fab4U/ProtoCounter_Tx13/ReadMe.md

# ProtoCounter Tx13

A versatile microcontroller system.
For a detailed description see

/documentation/protocounter_english.pdf

This project folder contains the Arduino library for operating the ProtoCounter. You will need the Arduino IDE (recommended version > 1.6) and the extension for ATtiny microcontrollers (https://github.com/SpenceKonde/ATTinyCore).
