fab4U/ProtoCounter_Tx13/documentation/proto-counter.pdf

2019/03/14 22:52 | 1/10 | Proto-Counter

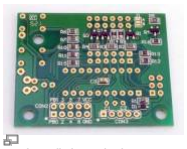
[picture p1: figure]

fab4U - http://www.doku.fab4u.de/

# Proto-Counter

Das universelle Mikrocontroller-Modul

ATtiny4313-Controller mit 4 kByte Flash Helle 7-Segmentanzeige, 3-stellig
Zwei Eingabetaster
5 bzw. 7 I/Os zur freien Verfügung
8 MHz-Quarz
Drehknopf (optional)
Zusätzliche I/Os über Schieberegister (optional) Einfache Programmierung per ISP
Betrieb an 3,3 oder 5 Volt
Programmierung mit der Arduino-IDE

## Beschreibung

Vorbestückte Platine

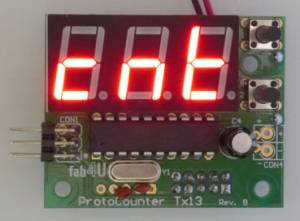
[picture p2: figure]

Egal ob Zähler, Timer oder Regler - mit dem Proto-Counter hast du im Handumdrehen deine Mikrocontroller-Anwendung verwirklicht. Er bringt alles mit, was man an Grundfunktionen benötigt: Anzeige, Taster, Drehknopf (optional) und einige I/Os für all die vielen Geräte und Helferlein, die du mal eben schnell realisieren möchtest. Die vorgefertigte Arduino-Library erleichtert dabei die Erstellung eigener Software.

Die Anschlüsse und Befestigungsbohrungen sind im Raster von 2,54 mm (1/10 Zoll) angelegt, so dass sich der Proto-Counter problemlos auf eine Lochrasterplatine aufstecken lässt. Alternativ dazu kann die Verbindung zu deiner Schaltung auch mit einem Flachbandkabel hergestellt werden.

Last update: 2018/07/03 21:12 | de:kits:protocounter:start http://www.doku.fab4u.de/de/kits/protocounter/start

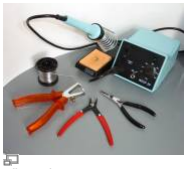
[picture p3: figure]
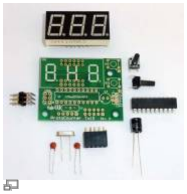
[picture p4: figure]

http://www.doku.fab4u.de/ | Printed on 2019/03/14 22:52

## Aufbau

Lötwerkzeug

Durch die bedrahteten Bauteile ist der Aufbau leicht zu bewältigen und schnell erledigt. Alle SMD-Bauelemente sind bereits vorbestückt.

Benötigt werden die üblichen Werkzeuge zum Löten von Elektronikschaltungen. Grundlegende Fähigkeiten und Kenntnisse im Löten und Bestücken sind erforderlich.

Bauteile

Proto-Counter-Komponenten

Der Bausatz enthält:

1 vorbestückte Proto-Counter-Platine 1 7-Segment-Display, 3-stellig
2 Taster
1 Mikrocontroller (ATtiny4313)
1 Quarz (8 MHz)
2 Keramikkondensatoren (15 pF) 1 Elektrolytkondensator (100 µF) 1 Stiftleiste 2×3-polig, gewinkelt 1 Buchsenleiste 2×5-polig, gerade

Bauanleitung

1. Zuerst werden der Quarz und die beiden Keramikkondensatoren bestückt. Die Keramikkondensatoren kommen in Pin1+2 bzw. Pin3+4 von CON3.
Wer keine quarzgenaue Zeitbasis braucht, lässt stattdessen Quarz und Kondensatoren einfach

2019/03/14 22:52 | 3/10 | Proto-Counter
weg und verwendet den internen RC-Oszillator. Hierdurch stehen an CON3 nun zwei weitere I/Os (PA0 und PA1) für eigene Zwecke zur Verfügung.

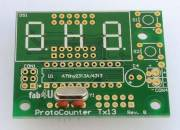
[picture p5: figure]

2. Danach folgt die gewinkelte Stiftleiste. Sie dient später zur Programmierung (Atmel ISP).

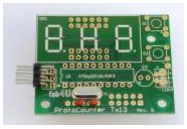
[picture p6: figure]

3. Nun kommt der Prozessor an die Reihe. Damit er sich leichter in die Platine einsetzen lässt, empfiehlt es sich, die Beinchen vorher entsprechend dem Lochabstand etwas zusammenzubiegen. Dies ist mit einem Pin-Abrichtwerkzeug schnell erledigt. Beim Bestücken bitte auf die Polarität achten. Die Kerbe am IC muss mit dem Bestückungsaufdruck auf der Platine übereinstimmen.

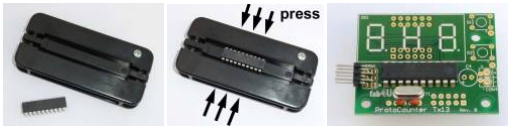
[picture p7: figure]

4. Danach folgt der Elektrolykondensator. Hier bitte ebenfalls auf die Polarität achten. Der Minuspol ist am Bauteil durch einen weissen Balken markiert. Auch beim Display ist die richtige Orientierung wichtig. Die Dezimalpunkte liegen beim Prozessor.

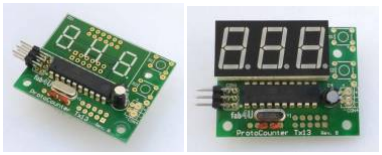
[picture p8: figure]

5. Schließlich werden noch die beiden Taster neben dem Display eingelötet.

6.

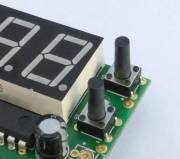
[picture p9: figure]
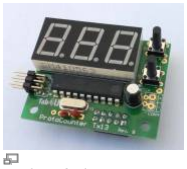
[picture p10: figure]

Fertig aufgebauter ProtoCounter

Zum Schluss wird auf der Rückseite die Buchsenleiste bestückt und von der Vorderseite verlötet. Wer den ProtoCounter über ein Flachbandkabel mit seiner Applikation verbinden will, kann die Buchse auch durch einen 10-poligen Wannenstecker ersetzen.

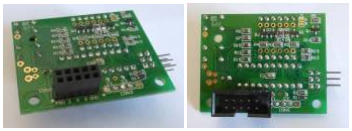
[picture p11: figure]

Und schon ist der ProtoCounter fertig! Jetzt musst du nur noch die Versorgung anschliessen (5 V=) und den Prozessor programmieren.

## Hardware

Anschlüsse

ISP-Anschluss

Der ISP-Anschluss entspricht der bei Atmel-AVR-Prozessoren üblichen Belegung.

< 16em 6em 2em 2em 6em >
Signal Pin Pin Signal
MISO | 1 | 2 | VCC
SCK | 3 | 4 | MOSI
RESET | 5 | 6 | GND

2019/03/14 22:52 | 5/10 | Proto-Counter
Applikations-Port

Hier sind die I/O-Pins von Port B herausgeführt. Es sind auch die Pin-Bezeichnungen unter Arduino angegeben. Die Pins PB5-7 werden für die Ansteuerung des Displays und die Abfrage der Taster benötigt.

< 28em 6em 6em 2em 2em 6em 6em >
Arduino | Signal Pin Pin Signal Arduino
D9 | PB0 | 1 | 2 | PB1 | D10
D11* | PB2 | 3 | 4 | PB3 | D12*
D13* | PB4 | 5 | 6 | PB5 | D14
D15 | PB6 | 7 | 8 | PB7 | D16
| GND | 9 | 10 | VCC

* = PWM port

Zusatz-Port

Betreibt man den Prozessor über den internen RC-Oszillator, braucht man den Quarz und die beiden Keramikkondensatoren nicht zu bestücken. Es stehen an CON3 dann zwei weitere I/Os zur Verfügung.

< 14em 2em 6em 6em >
Pin | Signal Arduino
1 | GND
2 | PA0 | D3
3 | GND
4 | PA1 | D2
5 | VCC

Versorgung

Die Versorgung kann mit einer geregelten Gleichspannung von 3,3 V oder 5 V erfolgen. Es existieren mehrere Anschlussmöglichkeiten:

über CON 4: Hier kann ein Stecker im 2,54 mm-Rastermaß oder eine kleine Schraubklemme mit 3,5 mm Pinabstand eingelötet werden.
Versorgung durch die Applikationsschaltung über die Buchsenleiste CON2
Per Batteriekasten auf der Rückseite (2 AAA-Batterien)

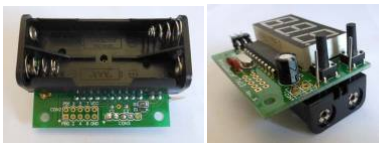
[picture p12: figure]

Die Helligkeit der LED-Anzeige variiert mit der Höhe der Versorgungsspannung. Als Ausgleich lässt sich daher in der Software die Helligkeit in drei Stufen anpassen (Parameter DIMMING in ProtoCounter.h).

Programmierung

Der ProtoCounter wird über den 6-poligen ISP-Anschluss programmiert. Hierzu ist ein entsprechendes Programmiergerät erforderlich wie z. B. der AVRISP mkII (http://www.atmel.com/tools/avrispmkii.aspx) von Atmel oder der USBasp (http://www.fischl.de/usbasp/) von Thomas Fischl.

Die Fuses müssen wie folgt eingestellt werden:

LOW | = 0xFF
HIGH | = 0xDF
EXTENDED = 0xFF

Anzeige

Helligkeit

Die Helligkeit der Anzeige und damit auch der Stromverbrauch des ProtoCounters kann über den Paramter dimming angepasst werden. Sinnvolle Werte für das Dimming liegen zwischen 0 und 9.

ProtoCounter pc; | // create a ProtoCounter instance
pc.dimming = 8; | // set dimming (0 = no dimming)

Dezimalpunkt

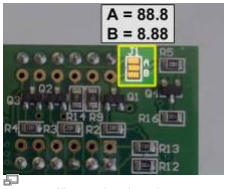
[picture p13: figure]

Jumper für Dezimalpunkt

Der Dezimalpunkt kann über einen Lötjumper fest eingestellt werden. In Position A hat die Anzeige eine, in Position B zwei Nachkommastellen. Bei offenem Jumper ist der Dezimalpunkt ausgeschaltet.

Die eingestellte Anzahl an Nachkommastellen wird dann im Programm festgelegt.

ProtoCounter pc; // create a ProtoCounter instance

2019/03/14 22:52 | 7/10 | Proto-Counter
pc.decimal_places = 1; // number of decimal places (range 0..2)

Wichtiger Hinweis
Soll der Dezimalpunkt zusammen mit externen Schieberegistern verwendet werden, müssen die Leitungen für die Input- bzw. Outputdaten auf freie Pins (z. B. Pins PB2 und PB3) verlegt werden.

/* ProtoCounter.h */
#define SH_REG_OUT_BIT | 2 | // data out bit number

#define SH_REG_IN_BIT 3 | // data in bit number

Drehknopf

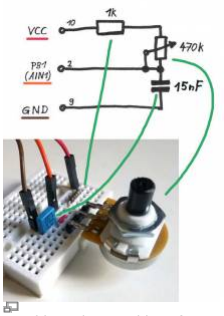
[picture p14: figure]

Anschluss eines Drehknopfs

Einstellungen mit einen Drehknopf vorzunehmen ist praktisch und intuitiv. Deshalb bietet auch der ProtoCounter diese Möglichkeit. An Pin PB1 (AIN1) lässt sich ein Potentiometer anschliessen, das zur Eingabe von Werten benutzt werden kann. Der Wertebereich geht von 0 bis maximal 250. Man benötigt folgende Bauteile:

Potentiometer 470 k
Widerstand 1 k
Kondensator 15 nF

Der Schaltplan rechts zeigt, wie man sie mit dem ProtoCounter verbindet.

Die Bauteilwerte sind nur Anhaltspunkte. Insbesondere Potentiometer haben oft einen etwas größeren Widerstandsbereich als ihr Nennwert angibt. Der Kondensator sollte nicht größer als 33 nF gewählt werden. Der Widerstand muss immer größer als 1 k sein, was durch den 1 k Widerstand in Reihe mit dem Potentiometer gewährleistet wird. Die Zeitkonstante, also das Produkt von Kapazität und Widerstand, sollte ungefähr 10 ms betragen, um den Wertebereich gut auszunutzen.

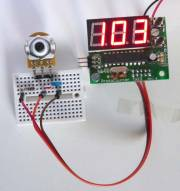
[picture p15: figure]

I/O-Erweiterung

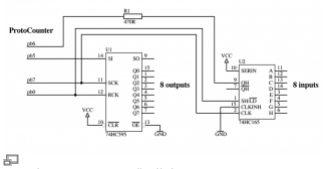
[picture p16: figure]

Erweiterung um zusätzliche I/Os

Mit minimalem Aufwand lässt sich der ProtoCounter um bis zu 32 Ausgänge und 32 Eingänge erweitern. Hierfür werden kostengünstige Standard-Schieberegister verwendet. Der Schaltplan zeigt beispielhaft die Erweiterung um jeweils 8 Ein- und Ausgänge. Man benötigt:

Schieberegister 74HC595 für jeweils 8 Ausgänge
Schieberegister 74HC165 für jeweils 8 Eingänge
Widerstand 470

Natürlich kann man auch nur Eingänge oder nur Ausgänge hinzufügen. Die gewünschte Anzahl an auszugebenden bzw. einzulesenden Bits wird im Headerfile angegeben.

/* ProtoCounter.h */
// external shift register
// Data is shifted out with MSB first.
// To disable the external shift register set BITCOUNT to 0
#define SH_REG_IN_BITCOUNT | 8 | // number of input shift register bits

(range 0..32)
#define SH_REG_OUT_BITCOUNT | 8 | // number of output shift register bits

(range 0..32)

Montage

Die Anschlüsse und Befestigungsbohrungen des ProtoCounters sind im Raster von 2,54 mm
(1/10 Zoll) angelegt, so dass sich der Proto-Counter problemlos auf eine Lochrasterplatine aufstecken

2019/03/14 22:52 | 9/10 | Proto-Counter
lässt. Genaue Koordinaten in mil (= 1/1000 Zoll) enthält die Maßzeichnung. (http://www.doku.fab4u.de/_media/de/kits/protocounter/protocounter_dimensions.pdf) 12 mm-Distanzbolzen sorgen für den richtigen Abstand. Über 10 mm-Distanzbolzen kann der ProtoCounter mit einer passenden Frontplatte verschraubt werden. Wenn man die Maßzeichnung 1:1 ausdruckt, kann sie als Bohrschablone dienen.

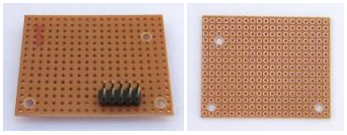
[picture p17: figure]
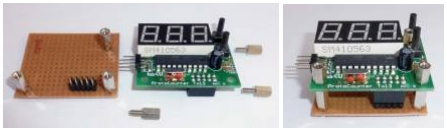
[picture p18: figure]

Alternativ kann die Verbindung zu deiner Schaltung auch mit einem Flachbandkabel hergestellt werden. Der ProtoCounter bietet genügend Platz für einen 10-poligen Wannenstecker.

## Software

Der ProtoCounter kann mit Hilfe der kostenlosen Arduino-IDE (http://www.arduino.cc/en/Main/Software) programmiert werden. Zusätzlich wird noch die Erweiterung für ATtiny-Prozessoren (http://github.com/SpenceKonde/ATTinyCore) benötigt. Die Installation ist auf der Github-Seite des Projekts unter der Überschrift Board Manager Installation beschrieben.

Für die Dokumentation der ProtoCounter-Software gibt es eine eigene Seite (Software-Dokumentation). (http://www.doku.fab4u.de/de/kits/protocounter/software)

## Download

Datei | Lizenz
Schaltplan (http://www.doku.fab4u.de/_media/de/kits/protocounter/protocounter_schematic.pdf) | CC-BY-SA
Bestückungsplan (http://www.doku.fab4u.de/_media/de/kits/protocounter/protocounter_assembly.pdf) | CC-BY-SA
Maßzeichnung (http://www.doku.fab4u.de/_media/de/kits/protocounter/protocounter_dimensions.pdf) | CC-BY-SA
ProtoCounter Arduino library (https://github.com/fab4U/ProtoCounter_Tx13) siehe license.md
Datenbaltt ATtiny4313 (http://www.atmel.com/Images/doc8246.pdf) | Copyright by Atmel

CC-BY-SA = Creative-Commons-Lizenz, (http://de.wikipedia.org/wiki/Creative_Commons) Namensnennung, Weitergabe unter gleichen Bedingungen CC0 = Creative-Commons-Lizenz, (http://de.wikipedia.org/wiki/Creative_Commons) ohne Einschränkungen

Proto-Counter, (http://www.doku.fab4u.de/tag/proto-counter?do=showtag&tag=Proto-Counter) Elektronik, (http://www.doku.fab4u.de/tag/elektronik?do=showtag&tag=Elektronik) Bausatz, (http://www.doku.fab4u.de/tag/bausatz?do=showtag&tag=Bausatz) 7-Segment, (http://www.doku.fab4u.de/tag/7-segment?do=showtag&tag=7-Segment) Arduino, (http://www.doku.fab4u.de/tag/arduino?do=showtag&tag=Arduino) ATtiny4313, (http://www.doku.fab4u.de/tag/attiny4313?do=showtag&tag=ATtiny4313) Mikrocontroller (http://www.doku.fab4u.de/tag/mikrocontroller?do=showtag&tag=Mikrocontroller)

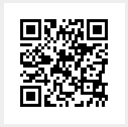
[picture p19: figure]

From:
http://www.doku.fab4u.de/ - fab4U

Permanent link:
http://www.doku.fab4u.de/de/kits/protocounter/start

Last update: 2018/07/03 21:12
