fab4U/ProtoCounter_Tx13/documentation/ProtoCounter Tx13 Schematic.pdf

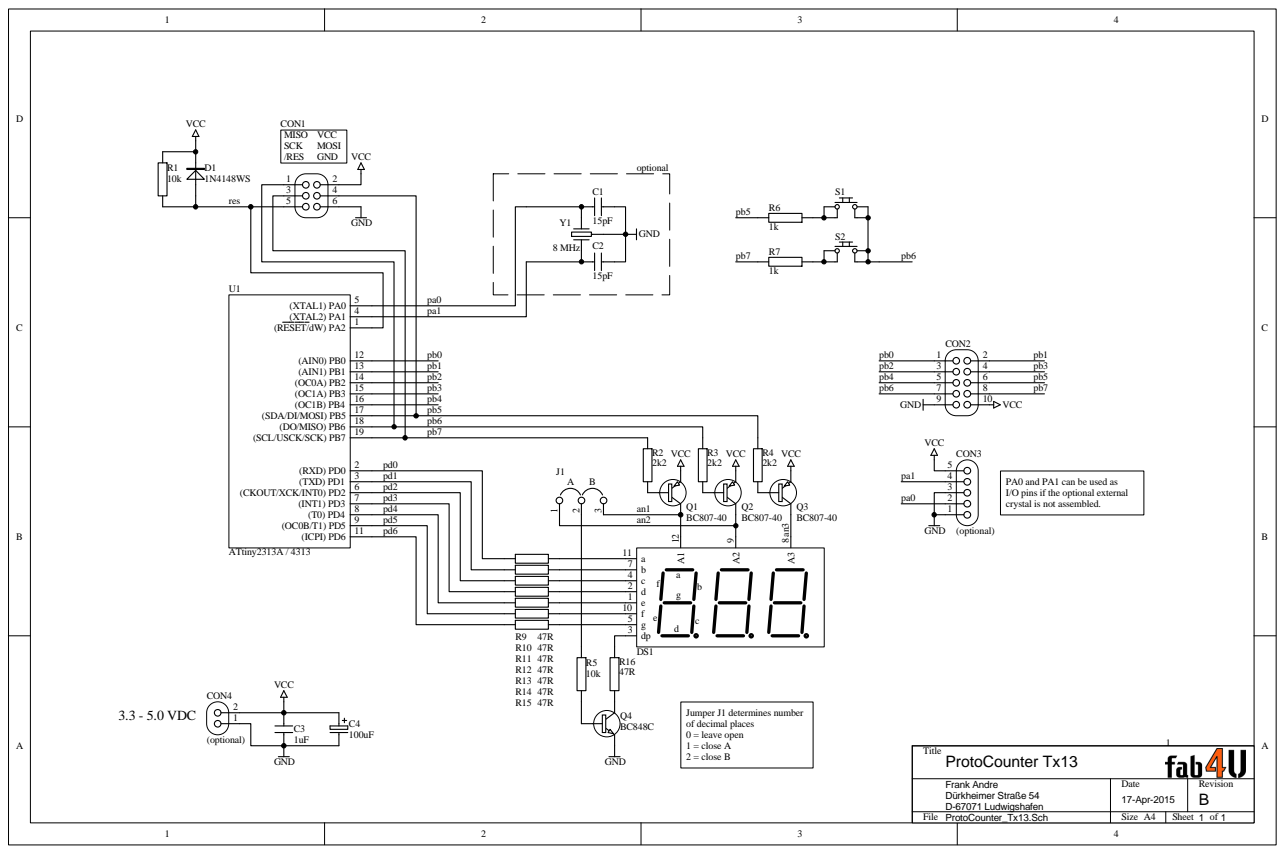
[picture p38: page 1]

PA0 and PA1 can be used as
I/O pins if the optional external
crystal is not assembled.
