fab4U/ProtoCounter_Tx13/documentation/IO-Extension Schematic.pdf

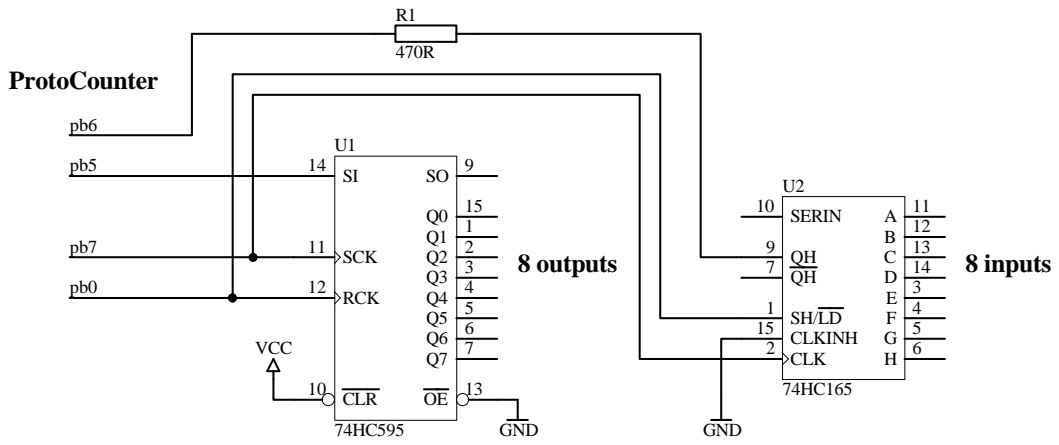
[picture p39: page 1]
