fab4U/ProtoCounter_Tx13/documentation/ProtoCounter Tx13 Assembly.pdf

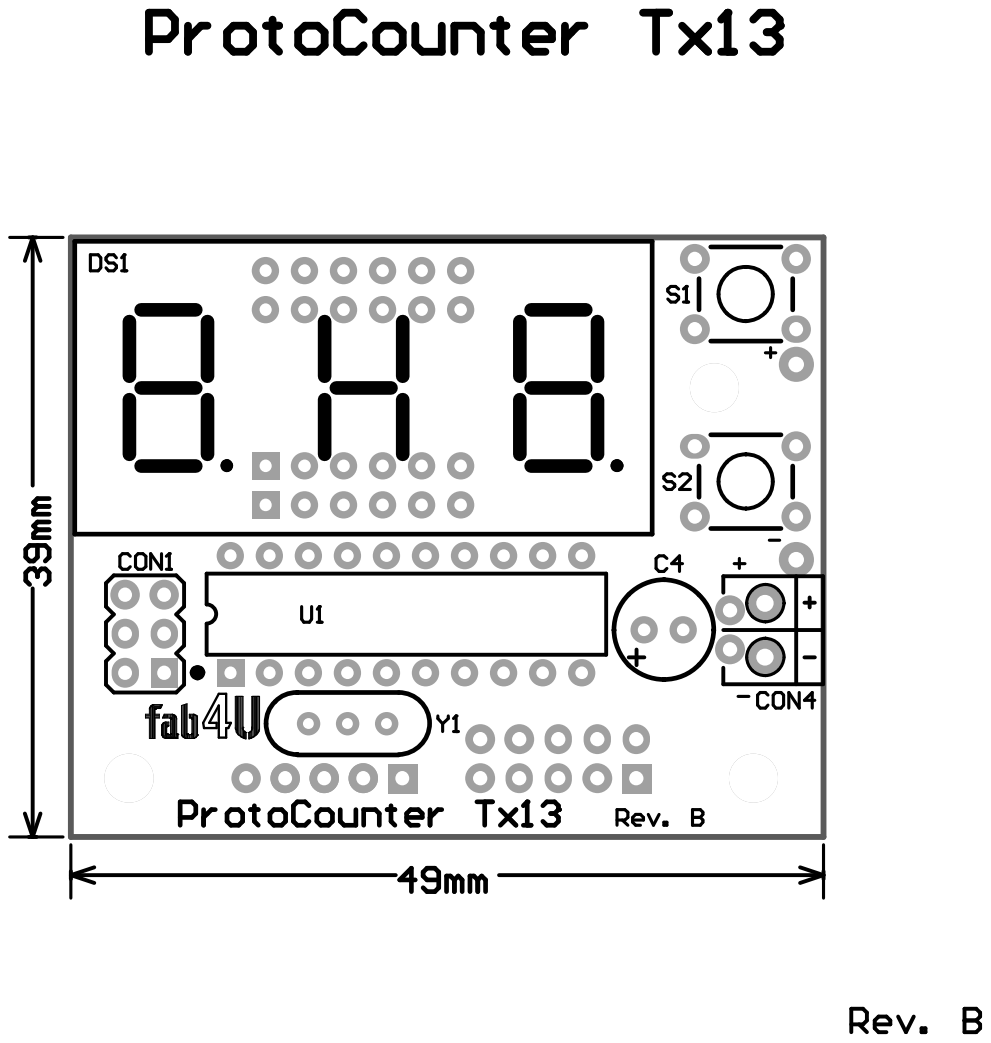
[picture p40: page 1]

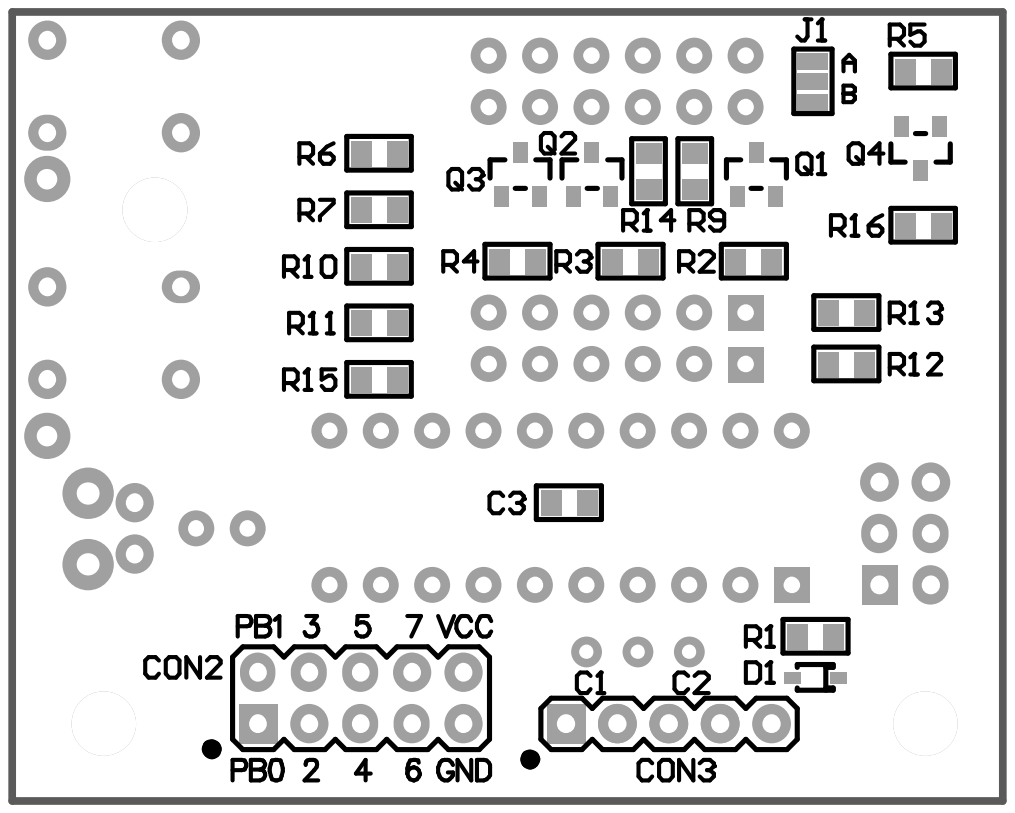
[picture p41: page 2]
