fab4U/ProtoCounter_Tx13/documentation/ProtoCounter Tx13 Dimensions.pdf

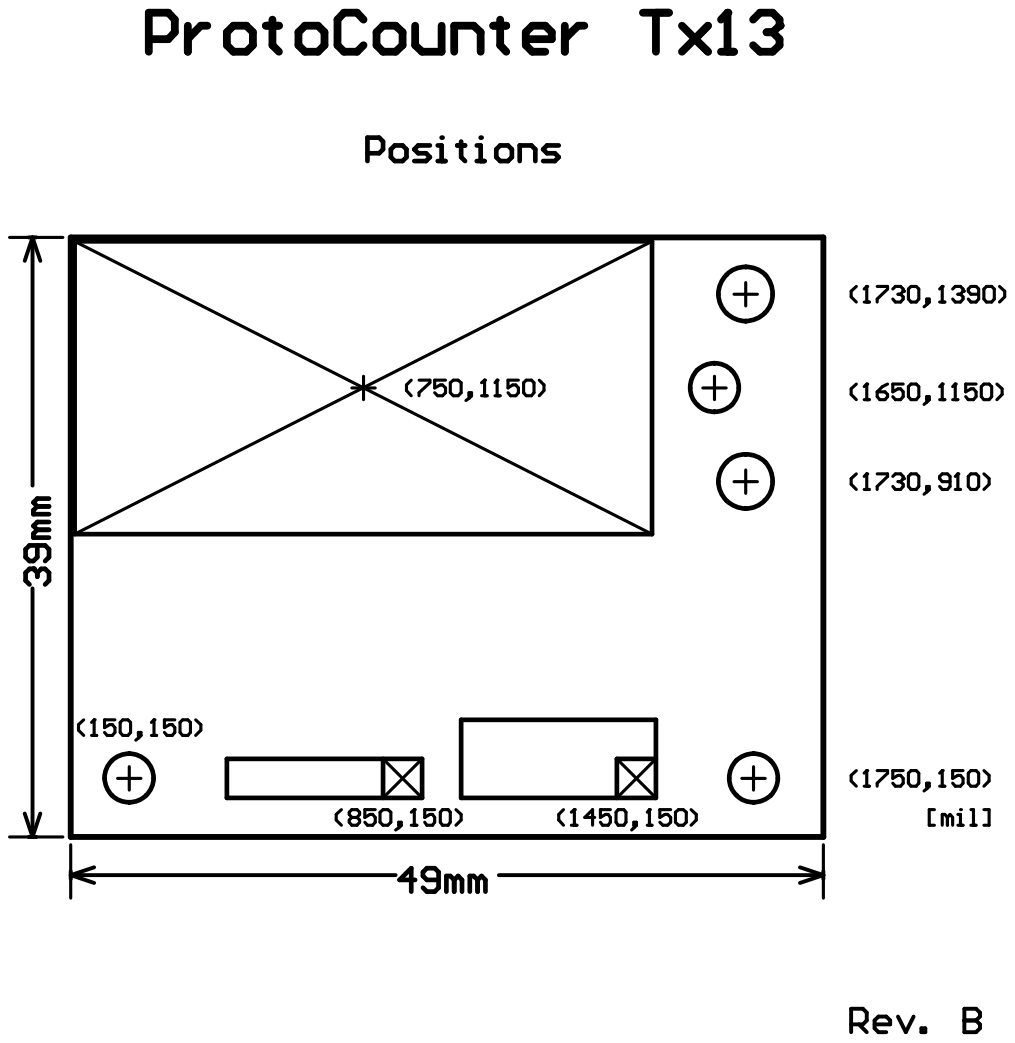
[picture p42: page 1]
