fab4U/ProtoCounter_Tx13/(notices)

Notices in the files:
ProtoCounter/ProtoCounter.cpp:
Copyright 2015: Frank Andre
License: see "license.md"
ProtoCounter/examples/EventCounter/EventCounter.ino:
Copyright 2016: Frank Andre
